goloveski/Gotoronic/README.md

# Gotoronic
オープンソースてやつだ好きにしろ。
クソコードって思うんなら直しといてくれよ！わーとるわそんなん。

V160425: 
         
         added STAND ALONE SETTING MODE (fine tuning)
         
         Serial Print Setting Parameters
         
         added front gear trim mode (trial)
         
         reduction data size for Atmega168

 V160905:  V3.0 released
         
         added STAND ALONE SETTING MODE2 (Rear zero&step tuning  Front tuning)
