goloveski/Gotoronic/簡易マニュアル160405.pdf

■Gotoronic
arduinoというMCU+開発環境を用い、市販で入手できる電子部品ほか材料を用いて 個人で手軽に電動変速器を自作するためのソリューションを提供する。

構成： MCUボード、変速機を駆動するサーボ、サーボ固定するステー、駆動用のロッド、 変速トリガを入れるスイッチ、バッテリ、ハーネス、etc…

■arduinoとは
[入門]Arduinoのはじめかた (http://matome.naver.jp/odai/2142565287041479101)
いわく： 一言でいうと「初心者でも簡単に扱えるマイコンボード」です。 また、オープンソース・ハードウェアと呼ばれるもので
回路からソフトウェアの全てが公開されています。
このため、これまで電子工作にあまりなじみのなかった人や マイコンのプログラミングに詳しくない人でも、
すぐに始める事が出来るように考えられています、
このため電子工作の入門にお勧めの一つとなっています。

用語： IDE＝開発環境。各自PCにインストールする。 スケッチ＝arduino本体（MCUボード）に書き込むプログラム。

参考サイト
Arduino 日本語リファレンス (http://www.musashinodenpa.com/arduino/ref/index.php)
オリジナルの英文を訳した文章が主。わりとわかりやすい。

workshop/ServoBasis/main (http://tetsuakibaba.jp/index.php?page=workshop/ServoBasis/main)
サーボライブラリ詳説

■サーボの制御について
Gotoronicでは"writeMicroseconds(uS)"コマンドを主に用いている。 サーボに対しマイクロ秒単位で角度を指定します。標準的なサーボでは、 1000で反時計回りにいっぱいまで振れます。2000で時計回りいっぱいです。 製品によっては、この範囲に収まらず700～2300といった値を取るものもあります。 ※1usecごとの移動θ目安　180deg/(2000usec-1000usec)＝0.18deg

Gotoronicでは1stギヤ位置をpos0として定義する。 この時サーボとしては動作最大角度に近い側になっている。 （※使うサーボ製品ごとに状況変わります）
段数が上がるにつれ、任意のステップ量だけ数値を減らす方向。

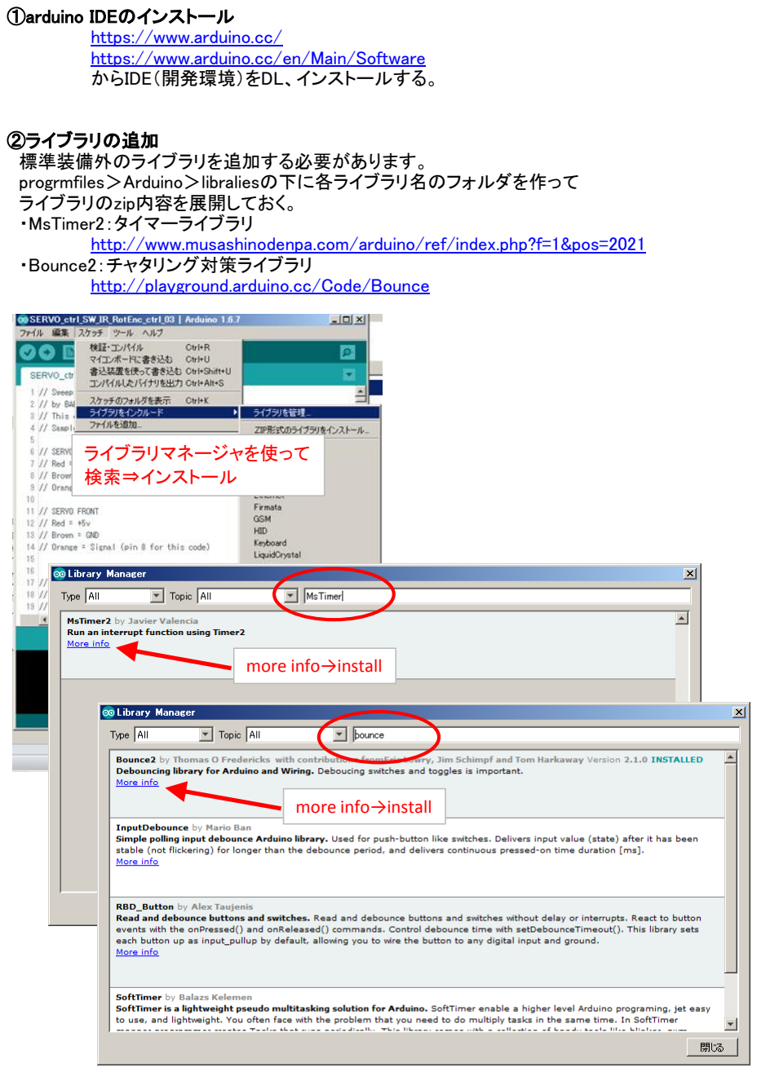
[picture p14: page 2]

①arduino IDEのインストール
https://www.arduino.cc/
https://www.arduino.cc/en/Main/Software からIDE（開発環境）をDL、インストールする。

②ライブラリの追加
標準装備外のライブラリを追加する必要があります。
progrmfiles＞Arduino＞libraliesの下に各ライブラリ名のフォルダを作って ライブラリのzip内容を展開しておく。
・MsTimer2：タイマーライブラリ
http://www.musashinodenpa.com/arduino/ref/index.php?f=1&pos=2021 ・Bounce2：チャタリング対策ライブラリ
http://playground.arduino.cc/Code/Bounce

ライブラリマネージャを使って
検索⇒インストール

more info→install

more info→install

③ardinoMCUボードの導入
③-１　promicroの場合
https://learn.sparkfun.com/tutorials/pro-micro--fio-v3-hookup-guide/installing-windows ドライバをDLしデスクトップ等に展開しておく。
MCUボードをPCにUSB接続する。
上記ドライバでセッティングする。
"ボードマネージャ"でMCU種を指定し、
設定する。上記URL中段からの説明参照。
注：MCU設定は5V16MHzを選ぶこと。

③-２　nano v3（モドキ）　の場合


https://www.arduino.cc/en/Main/ArduinoBoardNanohttp://www.dorapro.co.jp/engineerblog/?p=720 CH340ドライバをDLしデスクトップに展開しておく。 MCUボードをPCにUSB接続する。
上記ドライバでセッティングする。
"ボードマネージャ"でMCU種を指定し、設定する
Select "Arduino Diecimila, Duemilanove, or Nano w/ ATmega168" or "Arduino Duemilanove or Nano w/ ATmega328"
from the Tools > Board menu (according to the microcontroller on your board). 注：MCU設定は5V16MHzを選ぶこと。

④system

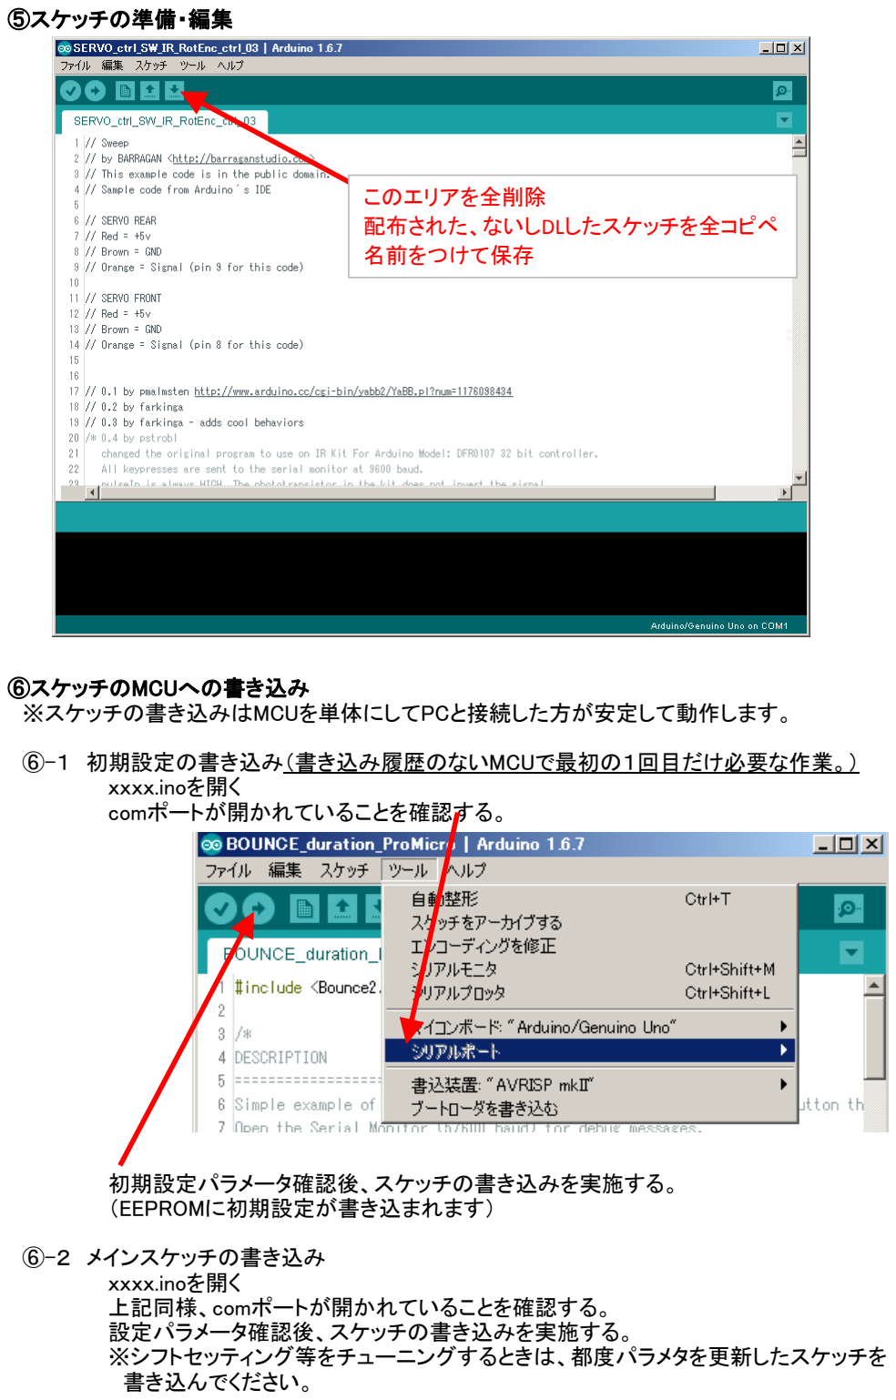
[picture p15: page 4]

⑤スケッチの準備・編集

⑥スケッチのMCUへの書き込み
※スケッチの書き込みはMCUを単体にしてPCと接続した方が安定して動作します。

⑥-１　初期設定の書き込み（書き込み履歴のないMCUで最初の１回目だけ必要な作業。） ｘｘｘｘ.inoを開く
comポートが開かれていることを確認する。

初期設定パラメータ確認後、スケッチの書き込みを実施する。 （EEPROMに初期設定が書き込まれます）

⑥-２　メインスケッチの書き込み
ｘｘｘｘ.inoを開く
上記同様、comポートが開かれていることを確認する。 設定パラメータ確認後、スケッチの書き込みを実施する。 ※シフトセッティング等をチューニングするときは、都度パラメタを更新したスケッチを 書き込んでください。

このエリアを全削除
配布された、ないしDLしたスケッチを全コピペ
名前をつけて保存

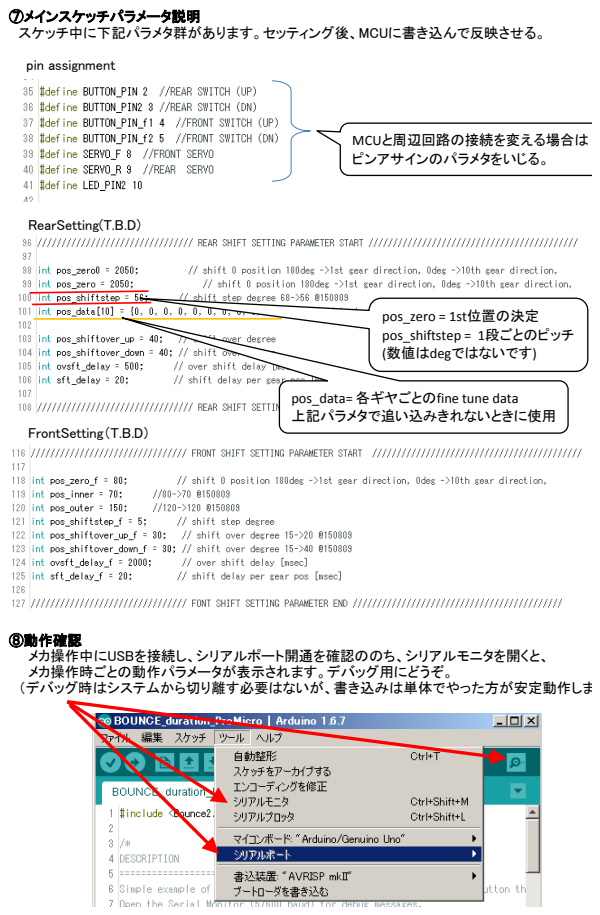
[picture p16: page 5]
pin assignment; RearSetting(T.B.D); FrontSetting（T.B.D); pos_zero = 1st位置の決定 pos_shiftstep = 1段ごとのピッチ (数値はdegではないです); MCUと周辺回路の接続を変える場合は ピンアサインのパラメタをいじる。

⑦メインスケッチパラメータ説明
スケッチ中に下記パラメタ群があります。セッティング後、MCUに書き込んで反映させる。

pos_data= 各ギヤごとのfine tune data
上記パラメタで追い込みきれないときに使用

⑧動作確認
メカ操作中にUSBを接続し、シリアルポート開通を確認ののち、シリアルモニタを開くと、
メカ操作時ごとの動作パラメータが表示されます。デバッグ用にどうぞ。
（デバッグ時はシステムから切り離す必要はないが、書き込みは単体でやった方が安定動作します。）
