goloveski/Gotoronic/簡易マニュアル_スタンドアロンセッティング_160506.pdf

■Gotoronicのスタンドアロンセッティング
パソコンなしでも微調整できるようにスタンドアロンセッティングのモードを持たせた。

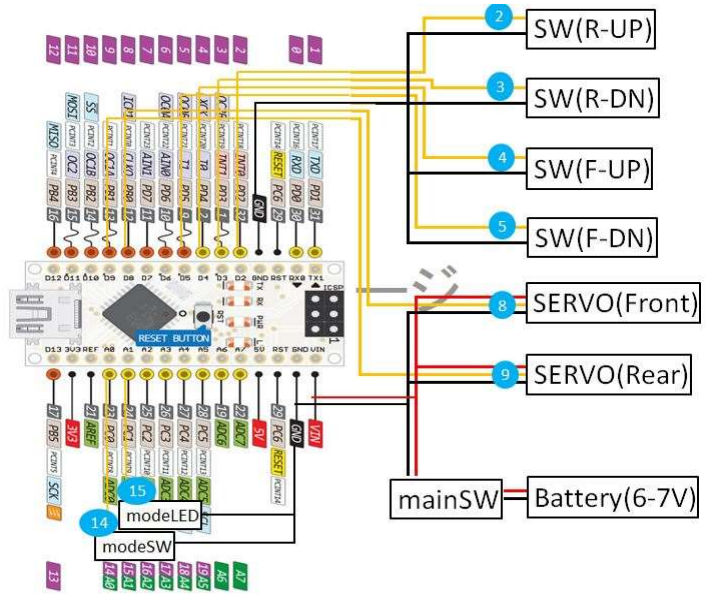
[picture p17: figure]

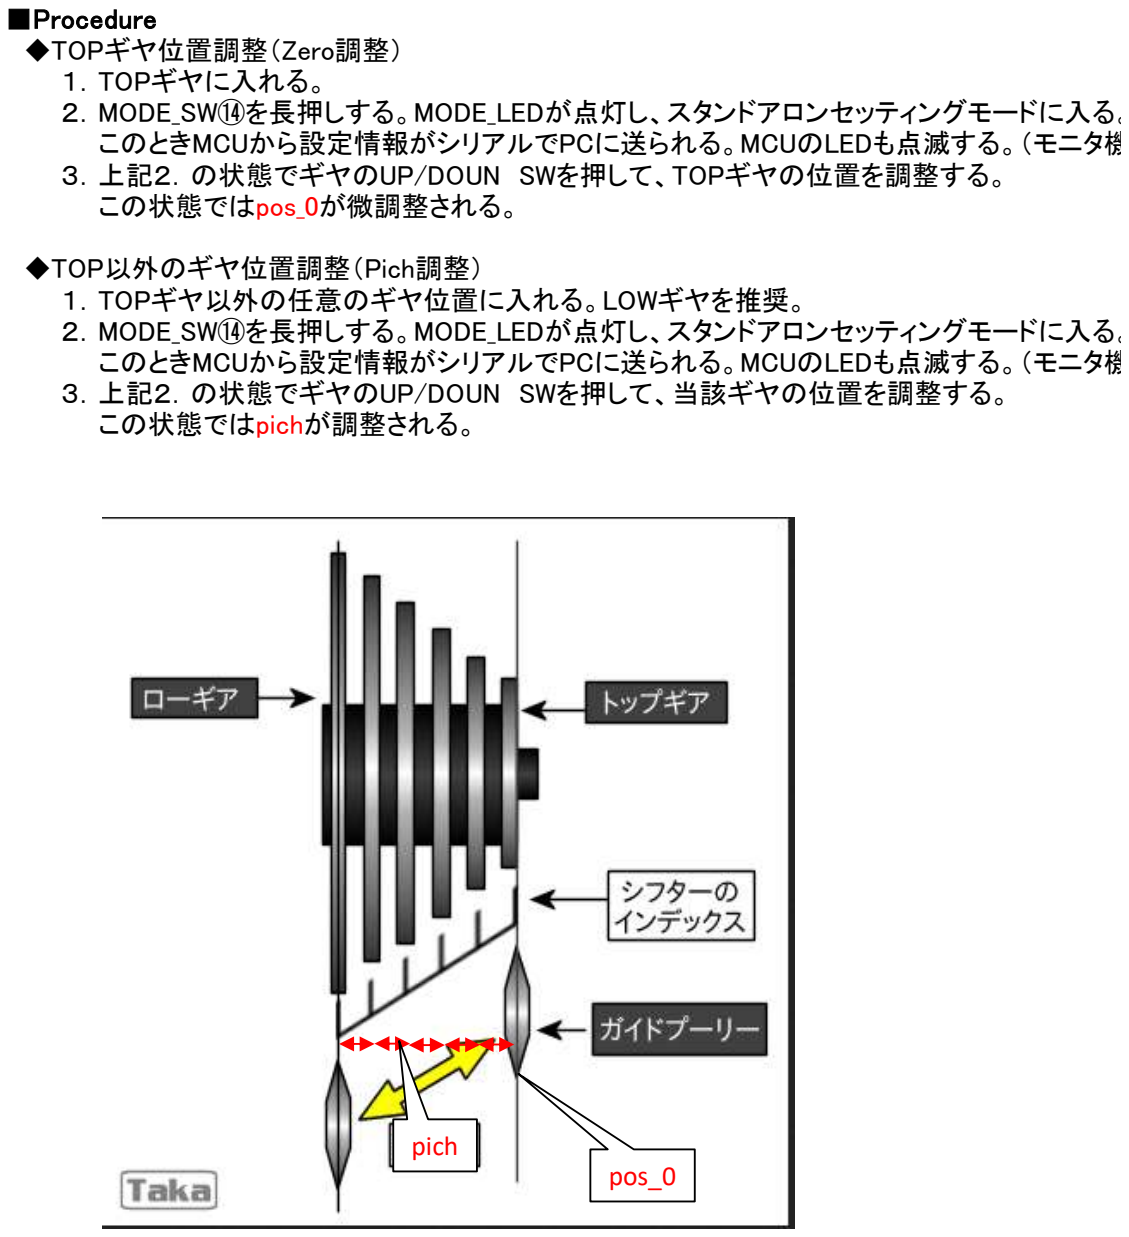
[picture p18: figure]
■Procedure ◆TOPギヤ位置調整（Zero調整） １．TOPギヤに入れる。 ２．MODE_SW⑭を長押しする。MODE_LEDが点灯し、スタンドアロンセッティングモードに入る。 このときMCUから設定情報がシリアルでPCに送られる。MCUのLEDも点滅する。（モニタ機能） ３．上記２．の状態でギヤのUP/DOUN SWを押して、TOPギヤの位置を調整する。 この状態ではpos_0が微調整される。; ◆TOP以外のギヤ位置調整（Pich調整） １．TOPギヤ以外の任意のギヤ位置に入れる。LOWギヤを推奨。 ２．MODE_SW⑭を長押しする。MODE_LEDが点灯し、スタンドアロンセッティングモードに入る。 このときMCUから設定情報がシリアルでPCに送られる。MCUのLEDも点滅する。（モニタ機能） ３．上記２．の状態でギヤのUP/DOUN SWを押して、当該ギヤの位置を調整する。 この状態ではpichが調整される。; pos_0; pich
