goloveski/Gotoronic/(commit log)

2016-09-04 Update and rename Gotoronic_V2.0_sketch.ino to Gotoronic_V3.0_sketch.ino
    added SETTING MODE ; Rear fine tune setting
    / BUTTON_PIN_MODESEL 14 to GND
    added SETTING MODE 2 ; Rear pos_zero & pos_shiftstep setting, Front setting
    / BUTTON_PIN_MODESEL2 16 to GND then BUTTON_PIN_MODESEL 14 to GND
2016-09-05 Update Gotoronic_V3.0_sketch.ino
    160906 bugfix
    [Gotoronic_V3.0_sketch.ino]
2017-10-27 Add files via upload
    ドキュメント更新・追加
